Bexin3/Snowduino/README.md

# Snowduino
Want to get your own PCB? These files are all you need (untested)
