Bexin3/Snowduino/PCBFiles/Snowduino Null.kicad_pcb

## KiCad design PCBFiles/Snowduino Null.kicad_pcb (2023-02-03)

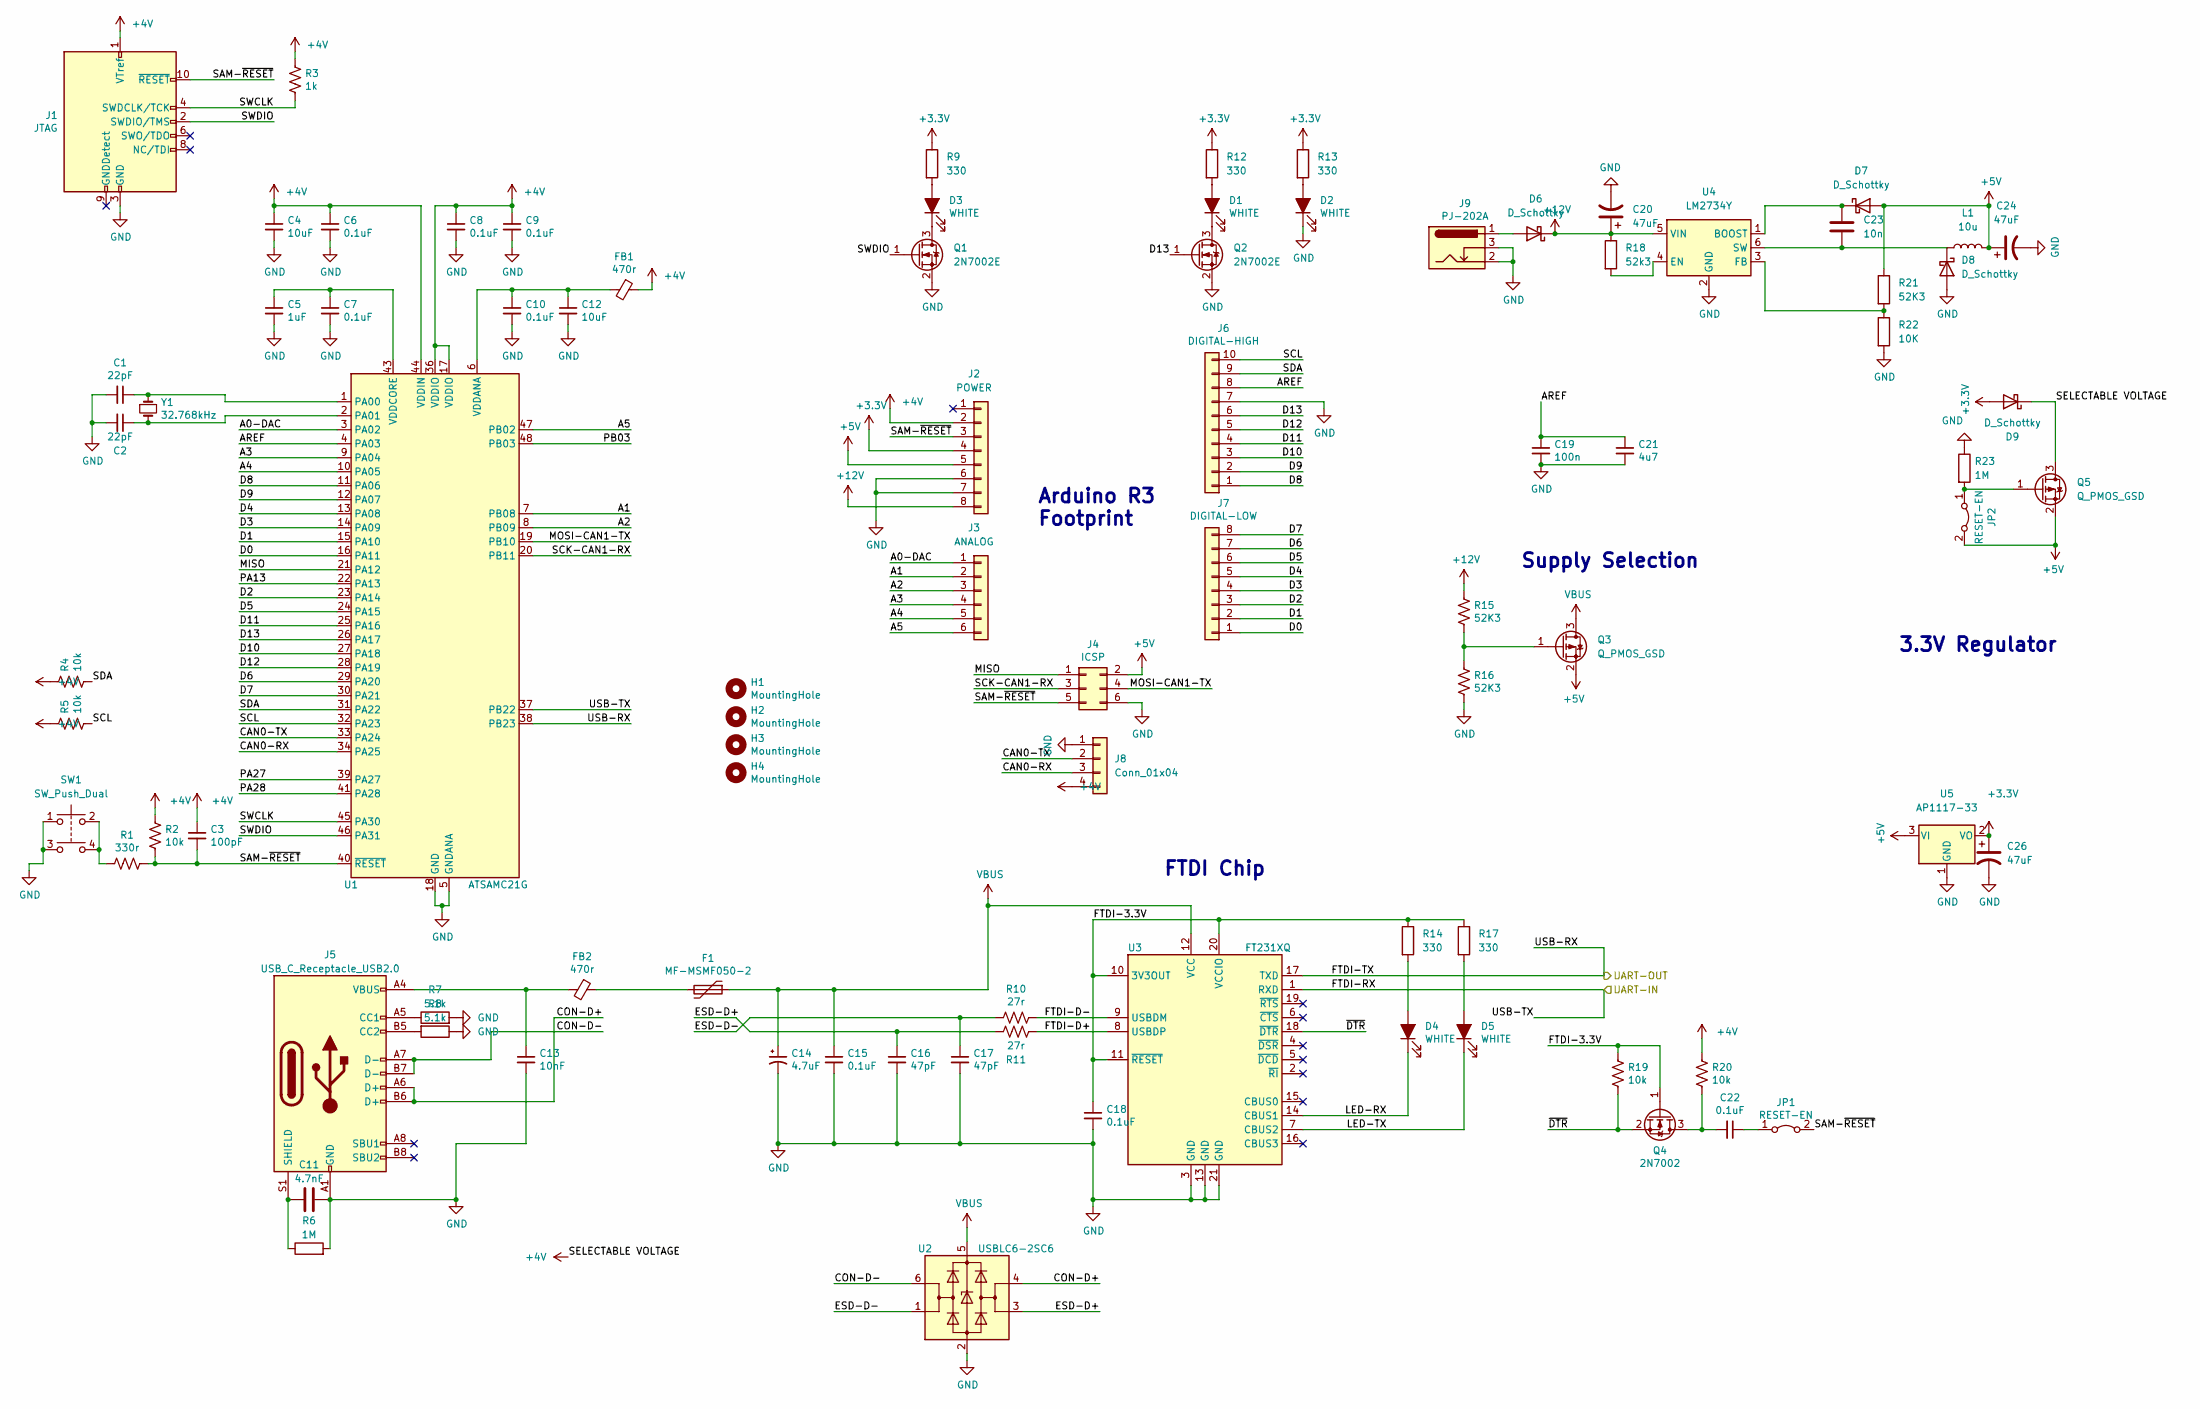
[picture p1: schematic Snowduino Null.kicad_sch, Uno]

Parts:
C1, C2: 22pF; C_0603_1608Metric
C3: 100pF; C_0603_1608Metric
C4, C12: 10uF; C_0805_2012Metric
C5: 1uF; C_0805_2012Metric
C6, C7, C8, C9, C10, C15, C18, C22: 0.1uF; C_0603_1608Metric
C11: 4.7nF; C_0603_1608Metric
C13: 10nF; C_0603_1608Metric
C14: 4.7uF; C_0805_2012Metric
C16, C17: 47pF; C_0603_1608Metric
C19: 100n; C_0603_1608Metric
C20, C24, C26: 47uF; CP_Elec_6.3x3.9
C21: 4u7; C_0603_1608Metric
C23: 10n; C_0603_1608Metric
D1, D2, D3, D4, D5: WHITE; LED_0603_1608Metric
D6, D7, D8: D_Schottky; D_SOD-123F
D9: D_Schottky; D_SOD-323
F1: MF-MSMF050-2; Fuse_1812_4532Metric
FB1: 470r; R_0603_1608Metric
FB2: 470r; R_0603_1608Metric; Part Number BLM18PG471SN1; Digikey PN 490-5223-1-ND
H1, H2, H3, H4: MountingHole; MountingHole_3.2mm_M3
J1: JTAG; PinHeader_2x05_P1.27mm_Vertical
J2: POWER; PinSocket_1x08_P2.54mm_Vertical
J3: ANALOG; PinSocket_1x06_P2.54mm_Vertical
J4: ICSP; PinHeader_2x03_P2.54mm_Vertical
J5: USB_C_Receptacle_USB2.0; USB_C_Receptacle_HRO_TYPE-C-31-M-12
J6: DIGITAL-HIGH; PinSocket_1x10_P2.54mm_Vertical
J7: DIGITAL-LOW; PinSocket_1x08_P2.54mm_Vertical
J8: Conn_01x04; PinHeader_1x04_P2.54mm_Vertical
J9: PJ-202A; DC005G25A20
JP1: RESET-EN; SolderJumper-2_P1.3mm_Bridged_RoundedPad1.0x1.5mm
JP2: RESET-EN; PinHeader_1x02_P1.27mm_Vertical
L1: 10u; L_6.3x6.3_H3
Q1, Q2: 2N7002E; SOT-23
Q3, Q5: Q_PMOS_GSD; SOT-23
Q4: 2N7002; SOT-23
R1: 330r; R_0603_1608Metric
R2, R4, R5, R19, R20: 10k; R_0603_1608Metric
R3: 1k; R_0603_1608Metric
R6, R23: 1M; R_0603_1608Metric
R7, R8: 5.1k; R_0603_1608Metric
R9, R12, R13, R14, R17: 330; R_0603_1608Metric
R10, R11: 27r; R_0603_1608Metric
R15, R16, R21: 52K3; R_0603_1608Metric
R18: 52k3; R_0603_1608Metric
R22: 10K; R_0603_1608Metric
SW1: SW_Push_Dual; PTS641SM31SMTR2LFS
U1: ATSAMC21G; TQFP-48_7x7mm_P0.5mm
U2: USBLC6-2SC6; SOT-23-6
U3: FT231XQ; QFN-20-1EP_4x4mm_P0.5mm_EP2.5x2.5mm
U4: LM2734Y; TSOT-23-6
U5: AP1117-33; SOT-223-3_TabPin2
Y1: 32.768kHz; Crystal_SMD_MicroCrystal_CC7V-T1A-2Pin_3.2x1.5mm

Connections:
+3V3: C26.1, D9.2 (A), J2.4, R9.1, R12.1, R13.1, U5.2 (VO)
+4V: C3.1, C4.1, C6.1, C8.1, C9.1, D9.1 (K), FB1.1, J1.1 (VTref), J2.2, J8.4, Q5.3 (D), R2.2, R3.1, R4.2, R5.2, R20.1, U1.17 (VDDIO), U1.36 (VDDIO), U1.44 (VDDIN)
+5V: C24.1, D7.2 (A), J2.5, J4.2, JP2.2 (B), L1.2, Q3.2 (S), Q5.2 (S), R21.1, U5.3 (VI)
+12V: C20.1, D6.1 (K), J2.8, R15.1, R18.1, U4.5 (VIN)
/A0-DAC: J3.1, U1.3 (PA02)
/A1: J3.2, U1.7 (PB08)
/A2: J3.3, U1.8 (PB09)
/A3: J3.4, U1.9 (PA04)
/A4: J3.5, U1.10 (PA05)
/A5: J3.6, U1.47 (PB02)
/AREF: C19.1, C21.1, J6.8, U1.4 (PA03)
/CAN0-RX: J8.3, U1.34 (PA25)
/CAN0-TX: J8.2, U1.33 (PA24)
/CON-D+: J5.A6 (D+), J5.B6 (D+), U2.4 (I/O2)
/CON-D-: J5.A7 (D-), J5.B7 (D-), U2.6 (I/O1)
/D0: J7.1, U1.16 (PA11)
/D1: J7.2, U1.15 (PA10)
/D2: J7.3, U1.23 (PA14)
/D3: J7.4, U1.14 (PA09)
/D4: J7.5, U1.13 (PA08)
/D5: J7.6, U1.24 (PA15)
/D6: J7.7, U1.29 (PA20)
/D7: J7.8, U1.30 (PA21)
/D8: J6.1, U1.11 (PA06)
/D9: J6.2, U1.12 (PA07)
/D10: J6.3, U1.27 (PA18)
/D11: J6.4, U1.25 (PA16)
/D12: J6.5, U1.28 (PA19)
/D13: J6.6, Q2.1 (G), U1.26 (PA17)
/ESD-D+: C16.1, R11.2, U2.3 (I/O2)
/ESD-D-: C17.1, R10.2, U2.1 (I/O1)
/FTDI-3.3V: C18.1, Q4.1 (G), R14.1, R17.1, R19.1, U3.10 (3V3OUT), U3.11 (~RESET), U3.20 (VCCIO)
/FTDI-D+: R11.1, U3.8 (USBDP)
/FTDI-D-: R10.1, U3.9 (USBDM)
/FTDI-RX: U1.37 (PB22), U3.1 (RXD)
/FTDI-TX: U1.38 (PB23), U3.17 (TXD)
/LED-RX: D4.1 (K), U3.14 (CBUS1)
/LED-TX: D5.1 (K), U3.7 (CBUS2)
/MISO: J4.1, U1.21 (PA12)
/MOSI-CAN1-TX: J4.4, U1.19 (PB10)
/PA13: U1.22 (PA13)
/PA27: U1.39 (PA27)
/PA28: U1.41 (PA28)
/PB03: U1.48 (PB03)
/SAM-~RESET: C3.2, J1.10 (~RESET), J2.3, J4.5, JP1.2 (B), R1.1, R2.1, U1.40 (~RESET)
/SCK-CAN1-RX: J4.3, U1.20 (PB11)
/SCL: J6.10, R5.1, U1.32 (PA23)
/SDA: J6.9, R4.1, U1.31 (PA22)
/SWCLK: J1.4 (SWDCLK/TCK), R3.2, U1.45 (PA30)
/SWDIO: J1.2 (SWDIO/TMS), Q1.1 (G), U1.46 (PA31)
/~DTR: Q4.2 (S), R19.2, U3.18 (~DTR)
GND: C1.2, C2.2, C4.2, C5.2, C6.2, C7.2, C8.2, C9.2, C10.2, C11.1, C12.2, C13.2, C14.2, C15.2, C16.2, C17.2, C18.2, C19.2, C20.2, C21.2, C24.2, C26.2, D2.1 (K), D8.2 (A), J1.3 (GND), J1.5 (GND), J2.6, J2.7, J4.6, J5.A1 (GND), J5.A12 (GND), J5.B1 (GND), J5.B12 (GND), J6.7, J8.1, J9.2, J9.3, Q1.2 (S), Q2.2 (S), R6.2, R7.2, R8.1, R16.2, R22.2, R23.1, SW1.1, SW1.3, U1.5 (GNDANA), U1.18 (GND), U1.35 (GND), U1.42 (GND), U2.2 (GND), U3.3 (GND), U3.13 (GND), U3.21 (GND), U4.2 (GND), U5.1 (GND)
unnamed: C1.1, U1.1 (PA00), Y1.1
unnamed: C2.1, U1.2 (PA01), Y1.2
unnamed: C5.1, C7.1, U1.43 (VDDCORE)
unnamed: C10.1, C12.1, FB1.2, U1.6 (VDDANA)
unnamed: C11.2, J5.S1 (SHIELD), R6.1
unnamed: C13.1, FB2.2, J5.A4 (VBUS), J5.A9 (VBUS), J5.B4 (VBUS), J5.B9 (VBUS)
unnamed: C22.1, JP1.1 (A)
unnamed: C22.2, Q4.3 (D), R20.2
unnamed: C23.1, D7.1 (K), U4.1 (BOOST)
unnamed: C23.2, D8.1 (K), L1.1, U4.6 (SW)
unnamed: D1.1 (K), Q2.3 (D)
unnamed: D1.2 (A), R12.2
unnamed: D2.2 (A), R13.2
unnamed: D3.1 (K), Q1.3 (D)
unnamed: D3.2 (A), R9.2
unnamed: D4.2 (A), R14.2
unnamed: D5.2 (A), R17.2
unnamed: D6.2 (A), J9.1
unnamed: F1.2, FB2.1
unnamed: J5.A5 (CC1), R7.1
unnamed: J5.B5 (CC2), R8.2
unnamed: JP2.1 (A), Q5.1 (G), R23.2
unnamed: Q3.1 (G), R15.2, R16.1
unnamed: R1.2, SW1.2, SW1.4
unnamed: R18.2, U4.4 (EN)
unnamed: R21.2, R22.1, U4.3 (FB)
VBUS: C14.1, C15.1, F1.1, Q3.3 (D), U2.5 (VBUS), U3.12 (VCC)

Notes on the sheet:
FTDI Chip
Arduino R3 Footprint
Supply Selection
3.3V Regulator

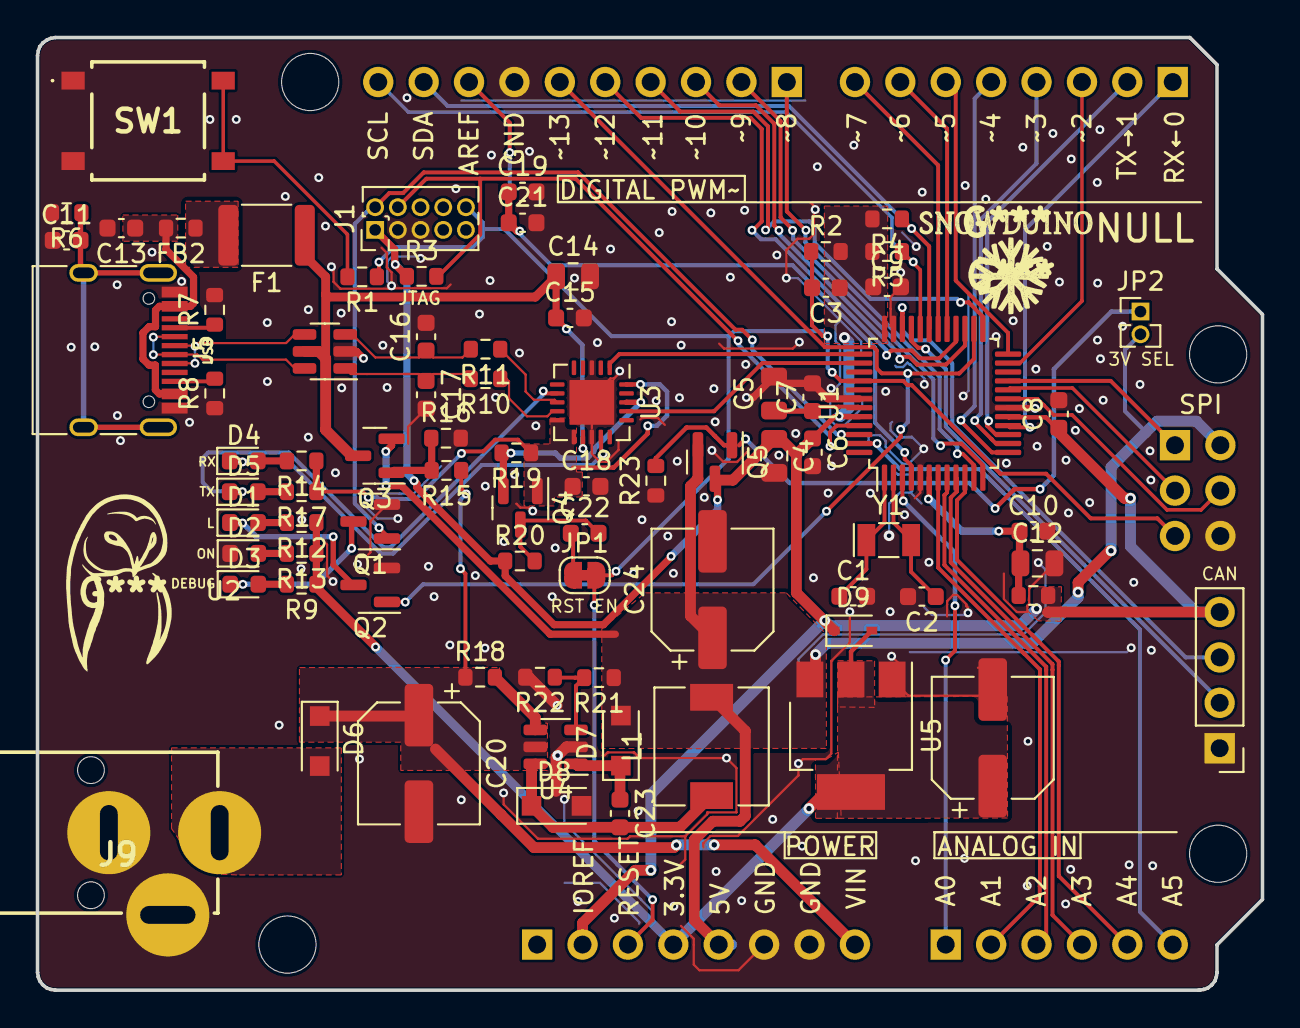
[picture p2: board Snowduino Null.kicad_pcb from above]

Board: 2 copper layers, 68.5 x 53.3 mm, 88 parts (0 on the bottom side), 75 nets.
